Abdelwadoud-ben-kridis/smart-self-balancing-robot/3d/right top leg .stl

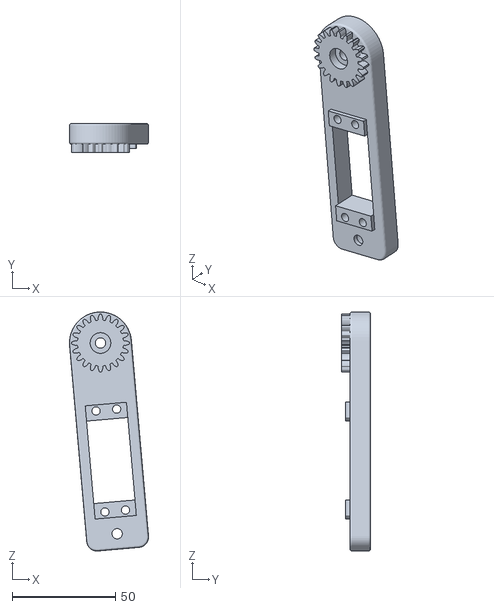
[picture p1: CAD file, 2026-06-13]
3d/right top leg .stl
38.2 x 14.0 x 115.5
