Abdelwadoud-ben-kridis/smart-self-balancing-robot/3d/top.stl

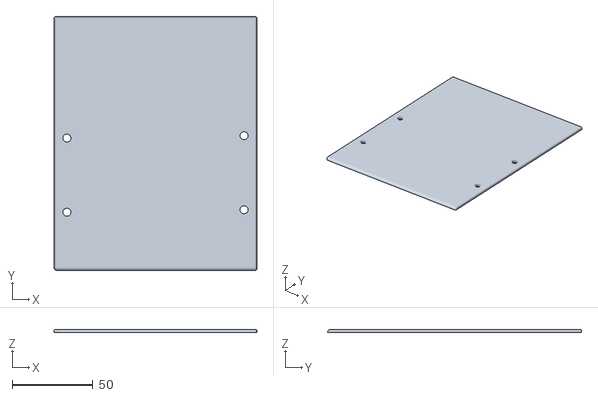
[picture p2: CAD file, 2026-06-10]
3d/top.stl
126.0 x 157.7 x 2.00
