Abdelwadoud-ben-kridis/smart-self-balancing-robot/3d/floor 2.stl

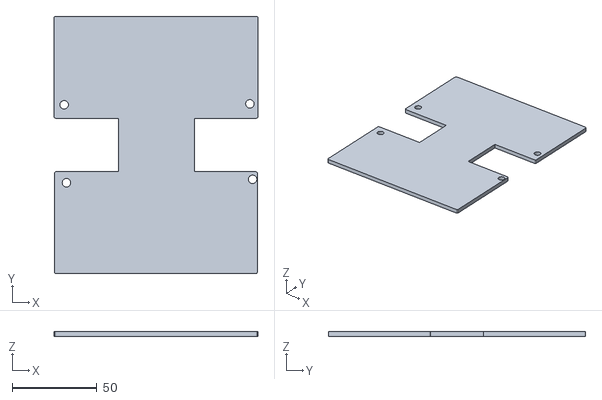
[picture p3: CAD file, 2026-06-10]
3d/floor 2.stl
120.0 x 151.5 x 3.00
