Abdelwadoud-ben-kridis/smart-self-balancing-robot/3d/Left Body_Side_Panel.stl

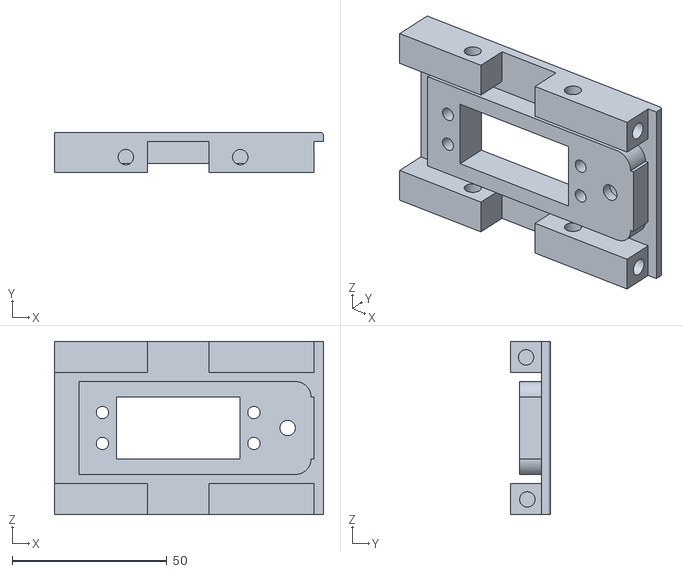
[picture p4: CAD file, 2026-06-10]
3d/Left Body_Side_Panel.stl
87.0 x 13.0 x 56.0
