Abdelwadoud-ben-kridis/smart-self-balancing-robot/3d/front flat.stl

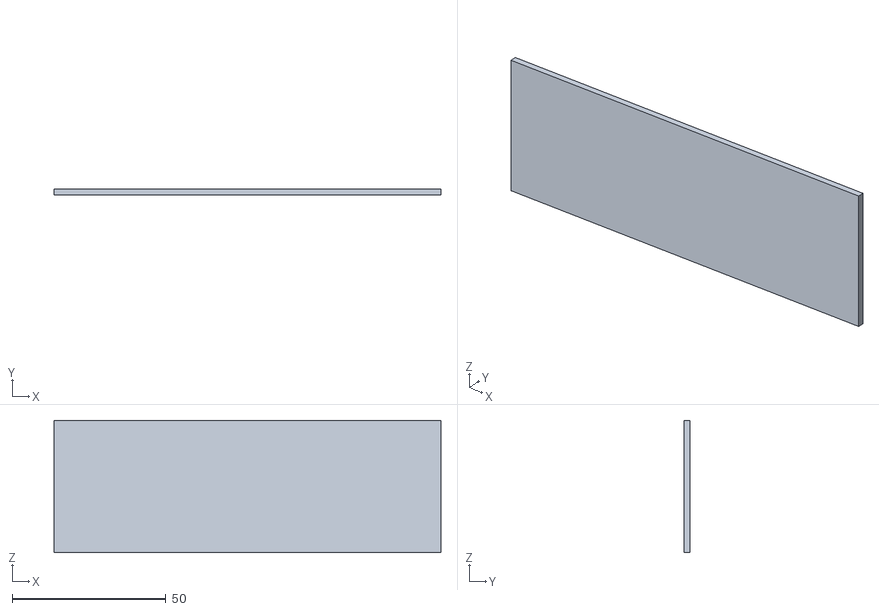
[picture p5: CAD file, 2026-06-08]
3d/front flat.stl
126.0 x 2.00 x 43.0
