Abdelwadoud-ben-kridis/smart-self-balancing-robot/3d/back right.stl

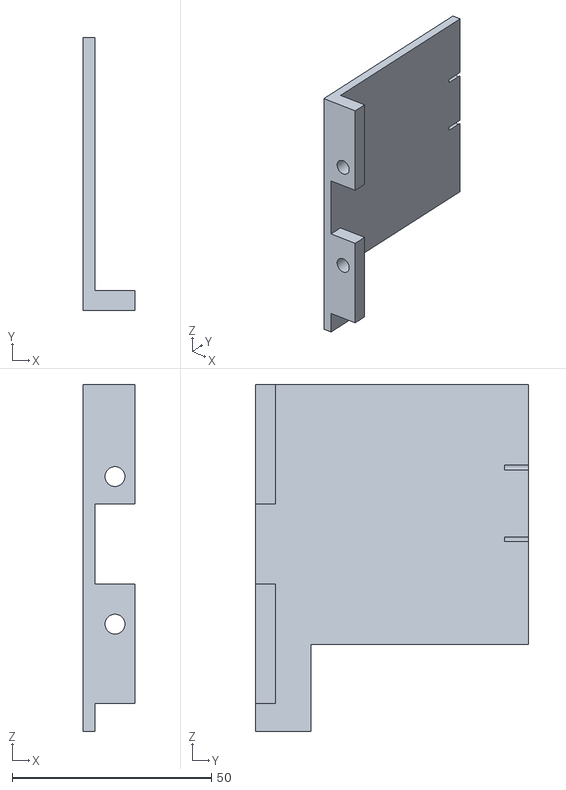
[picture p6: CAD file, 2026-06-08]
3d/back right.stl
13.0 x 68.5 x 87.0
