Abdelwadoud-ben-kridis/smart-self-balancing-robot/3d/bottom.stl

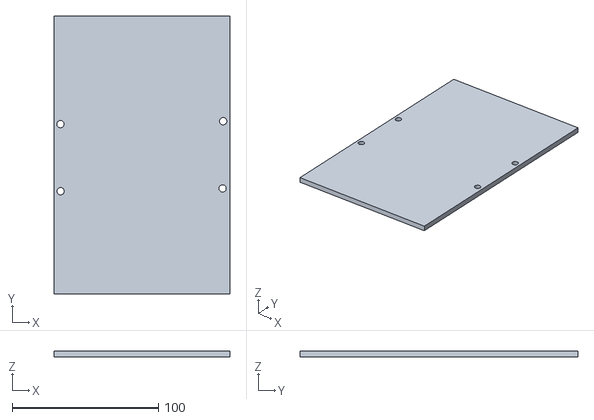
[picture p7: CAD file, 2026-06-08]
3d/bottom.stl
120.0 x 190.0 x 4.00
