Abdelwadoud-ben-kridis/smart-self-balancing-robot/3d/right bottom leg.stl

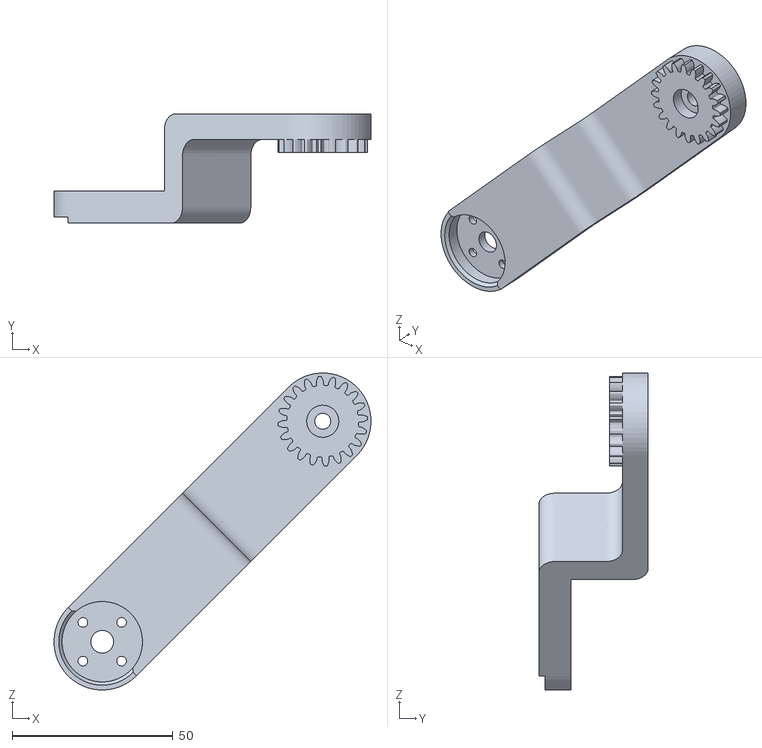
[picture p8: CAD file, 2026-06-08]
3d/right bottom leg.stl
98.5 x 34.0 x 98.5
