Abdelwadoud-ben-kridis/smart-self-balancing-robot/3d/front left.stl

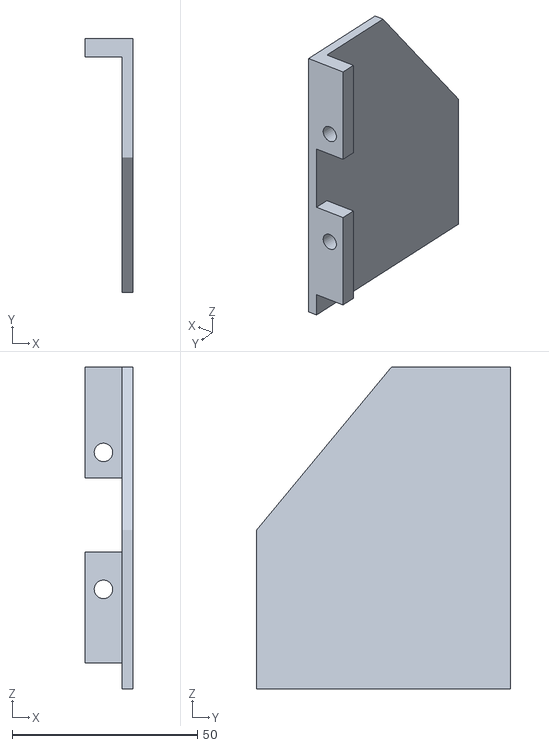
[picture p9: CAD file, 2026-06-08]
3d/front left.stl
13.0 x 68.5 x 87.0
