Abdelwadoud-ben-kridis/smart-self-balancing-robot/3d/back.stl

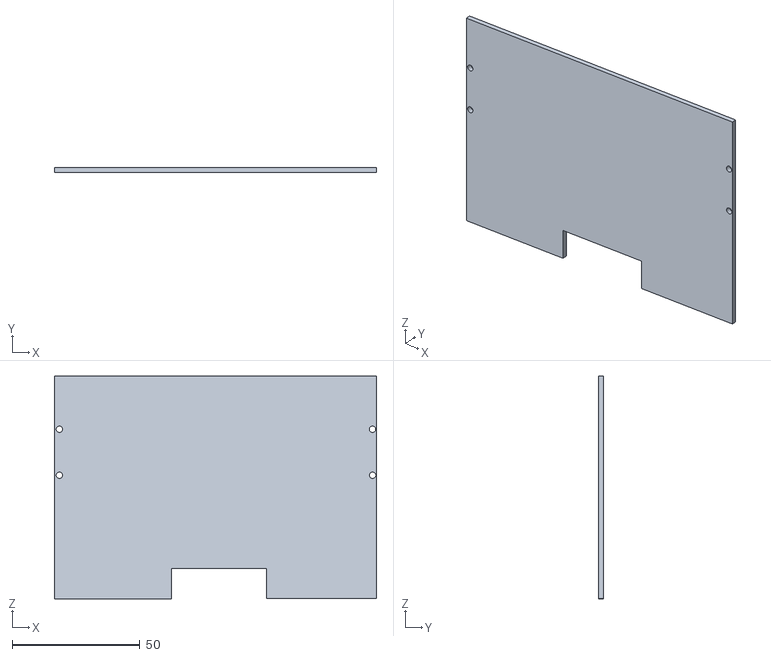
[picture p10: CAD file, 2026-06-08]
3d/back.stl
126.0 x 2.00 x 87.2
