Abdelwadoud-ben-kridis/smart-self-balancing-robot/(list of files, cad)

Other CAD files:
3d/left top leg.stl
3d/Right Body_Side_Panel.stl
3d/left bottom leg .stl
3d/robot.STEP
