Abdelwadoud-ben-kridis/smart-self-balancing-robot/wiring.html

01 SBR

Wiring Plan

◆ Hardware Documentation

# Complete Wiring Plan

Two-floor robot body (18×15 cm). Floor 1 (top): Raspberry Pi 5, ESP32, MPU-6500 GY module, 3.5″ SPI screen. Floor 2 (bottom): 3S battery, BMS, buck converters, TB6612FNG, PCA9685, signal conditioning PCB.

⚡

## Power Chain

11.1V · 3S

Battery feeds a BMS and a master power switch, then fans out to three regulated rails through the main 11.1 V bus.

3S 18650 → BMS → Power Switch → 11.1V Rail

Buck 1

6V

PCA9685 V+ rail and all 4× MG996R servos

Buck 2

5V

Raspberry Pi 5 (USB-C or GPIO 5V pin) and ESP32 VIN

Direct

11.1V

TB6612FNG VM motor power — bypasses regulation

3.3V rail: ESP32 onboard regulator → 3.3V → MPU-6500 VCC, PCA9685 logic VCC, signal conditioning PCB +3V3 rail

☷

## Signal Conditioning PCB

57×60 mm

Central routing board that filters encoder signals, distributes I2C, and breaks out all ESP32 connections through a single 9-pin header.

Power input (J6): pin 1 = +3V3 from ESP32, pin 2 = GND, pin 3 = +6V from Buck 1

J1 — Encoder 1 Left Motor

- 1 +3V3 → encoder VCC
- 2 GND
- 3 ENC1_A → R1 10kΩ → C2 1nF → filtered
- 4 ENC1_B → R2 10kΩ → C3 1nF → filtered

J2 — Encoder 2 Right Motor

- 1 +3V3 → encoder VCC
- 2 GND
- 3 ENC2_A → R3 10kΩ → C6 1nF → filtered
- 4 ENC2_B → R4 10kΩ → C7 1nF → filtered

J8 — IMU MPU-6500

- 1 +3V3 → IMU VCC
- 2 GND
- 3 I2C_SDA
- 4 I2C_SCL
- 5 MPU_INT → R7 4.7kΩ pull-up

J3 — PCA9685 I2C 4-pin

- 1 +3V3
- 2 GND
- 3 I2C_SDA
- 4 I2C_SCL

J4 — PCA9685 Power 2-pin

- 1 +6V
- 2 GND

RC filter cutoff: 1/(2π × 1kΩ × 10nF) ≈ 15.9 kHz — kills motor PWM switching noise

### J5 — ESP32 Output Header (9-pin)

Pin | Signal | ESP32 GPIO
1 | +3V3 | —
2 | GND | —
3 | I2C_SDA | GPIO 21
4 | I2C_SCL | GPIO 22
5 | ENC1_A (filtered) | GPIO 13
6 | ENC1_B (filtered) | GPIO 14
7 | ENC2_A (filtered) | GPIO 16
8 | ENC2_B (filtered) | GPIO 17
9 | MPU_INT | GPIO 4

⚙

## ESP32 GPIO Assignments

WROOM-32D

GPIO | Connected to | Function
21 | PCA9685 SDA | I2C SDA (400 kHz)
22 | PCA9685 SCL | I2C SCL (400 kHz)
5 | MPU-6500 CS | SPI chip select (idle HIGH)
18 | MPU-6500 CLK | SPI clock (VSPI)
19 | MPU-6500 MISO | SPI MISO (VSPI)
23 | MPU-6500 MOSI | SPI MOSI (VSPI)
25 | TB6612FNG PWMA | Left motor speed (PWM, 1 kHz)
26 | TB6612FNG PWMB | Right motor speed (PWM, 1 kHz)
27 | TB6612FNG AIN1 | Left motor direction 1
32 | TB6612FNG AIN2 | Left motor direction 2
33 | TB6612FNG BIN1 | Right motor direction 1
15 | TB6612FNG BIN2 | Right motor direction 2 (HIGH at boot — drive LOW in setup)
4 | MPU-6500 INT | IMU interrupt
13 | ENC1_A | Encoder 1 channel A
14 | ENC1_B | Encoder 1 channel B
16 | ENC2_A | Encoder 2 channel A
17 | ENC2_B | Encoder 2 channel B

⏻

## TB6612FNG Motor Driver

Dual MOSFET H-Bridge

TB6612FNG Pin | Connects to | Notes
VM | 11.1V battery | Motor power (max 15V — OK at 12.6V full charge)
VCC | +3V3 | Logic power
STBY | +3V3 | Tied HIGH — driver always enabled
GND | GND | —
PWMA | GPIO 25 | Left motor speed (PWM, 1 kHz)
AIN1 | GPIO 27 | Left motor direction
AIN2 | GPIO 32 | Left motor direction
PWMB | GPIO 26 | Right motor speed (PWM, 1 kHz)
BIN1 | GPIO 33 | Right motor direction
BIN2 | GPIO 15 | Right motor direction (HIGH at boot)
AO1+AO2 | Left JGB37-520 | Motor terminals
BO1+BO2 | Right JGB37-520 | Motor terminals

↻

## PCA9685 Servo Driver

I2C 0x40

Powered by 6V (V+ rail) and 3.3V (VCC logic). I2C bus from ESP32 via signal conditioning PCB.

Channel | Servo | Direction
CH0 | Left knee MG996R | Normal (pulse 150–600)
CH1 | Right knee MG996R | Reversed (pulse = 750 − normal)
CH2 | Left hip MG996R | Normal
CH3 | Right hip MG996R | Reversed (pulse = 750 − normal)
CH4–15 | Unused | —

Pulse map: 0° = 150, 90° = 375, 180° = 600
Sit position: knee 80°, hip −80° • Stand position: knee 0°, hip 0°

⌖

## MPU-6500 IMU

I2C 0x68

GY breakout module plugs into signal PCB J8 (5-pin socket). Interrupt pin routed through 4.7kΩ pull-up to ESP32.

Axis Convention

Pitch rate = gyro Y (gy)
Pitch angle = atan2(ax, az)

Interrupt

INT pin → R7 4.7kΩ pull-up → J5 pin 9 → ESP32 GPIO (TBD)

π

## Raspberry Pi 5

Floor 1

Power: 5V from Buck 2 → GPIO header pin 4 (or USB-C). Comms with ESP32: UART or USB (TBD).

### 3.5″ SPI Screen (HAT-style, direct on 40-pin header)

Display SPI0

- CS BCM 8
- MISO BCM 9
- MOSI BCM 10
- SCLK BCM 11

Control

- DC BCM 25
- RST BCM 27

Touch

- CS BCM 7
- IRQ BCM 17

⚙

## JGB37-520 Motors

With Encoders

Each motor has 6 wires — 2 for the motor, 4 for the quadrature encoder.

Wire | Color | Connects to
Motor + | — | TB6612FNG AO/BO pins
Motor − | — | TB6612FNG AO/BO pins
Encoder VCC | Red | Signal PCB J1/J2 pin 1 (+3V3)
Encoder GND | Black | Signal PCB J1/J2 pin 2 (GND)
Channel A | Green | Signal PCB J1/J2 pin 3
Channel B | White | Signal PCB J1/J2 pin 4

◎

## MG996R Servos

4× Joints

Standard 3-wire servo connectors plug directly into PCA9685 channel headers.

Wire | Color | Connects to
GND | Brown | PCA9685 GND rail
Power | Red | +6V (Buck 1 via PCA9685 V+ rail)
Signal | Orange | PCA9685 channel PWM output

↑
