Abdelwadoud-ben-kridis/smart-self-balancing-robot/pcb/robot pcb.kicad_pcb

## KiCad design pcb/robot pcb.kicad_pcb (2026-06-02)

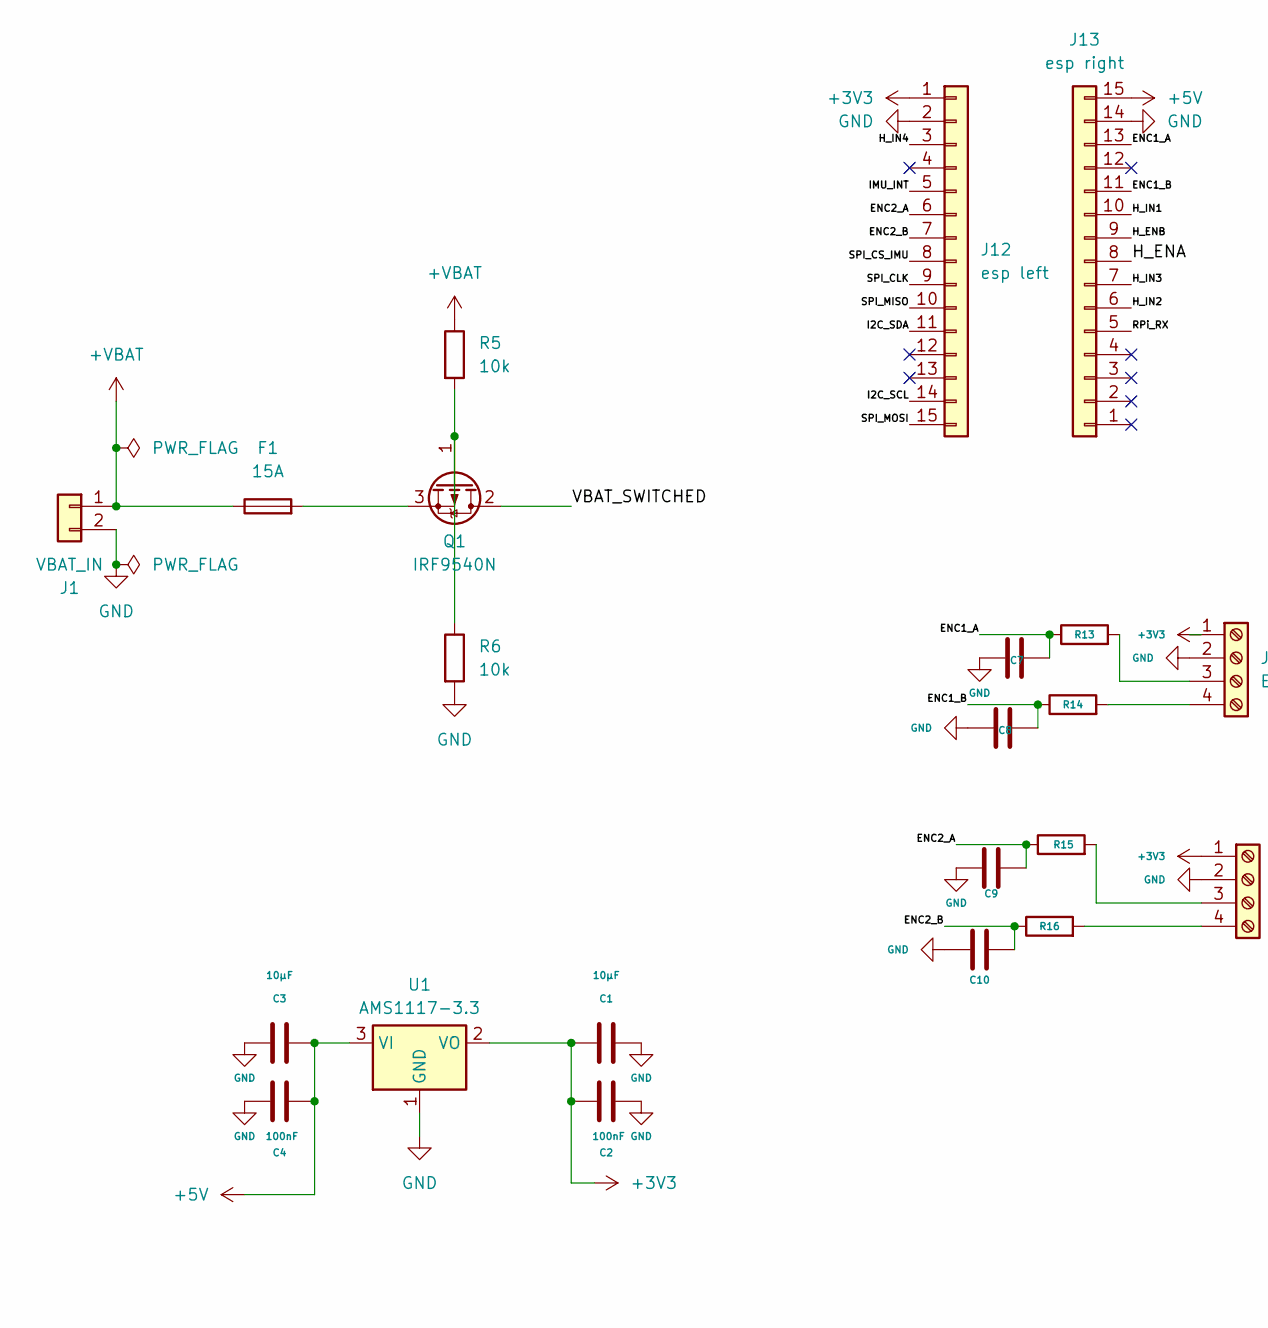
[picture p11: schematic robot pcb.kicad_sch, part in row 1, column 1]

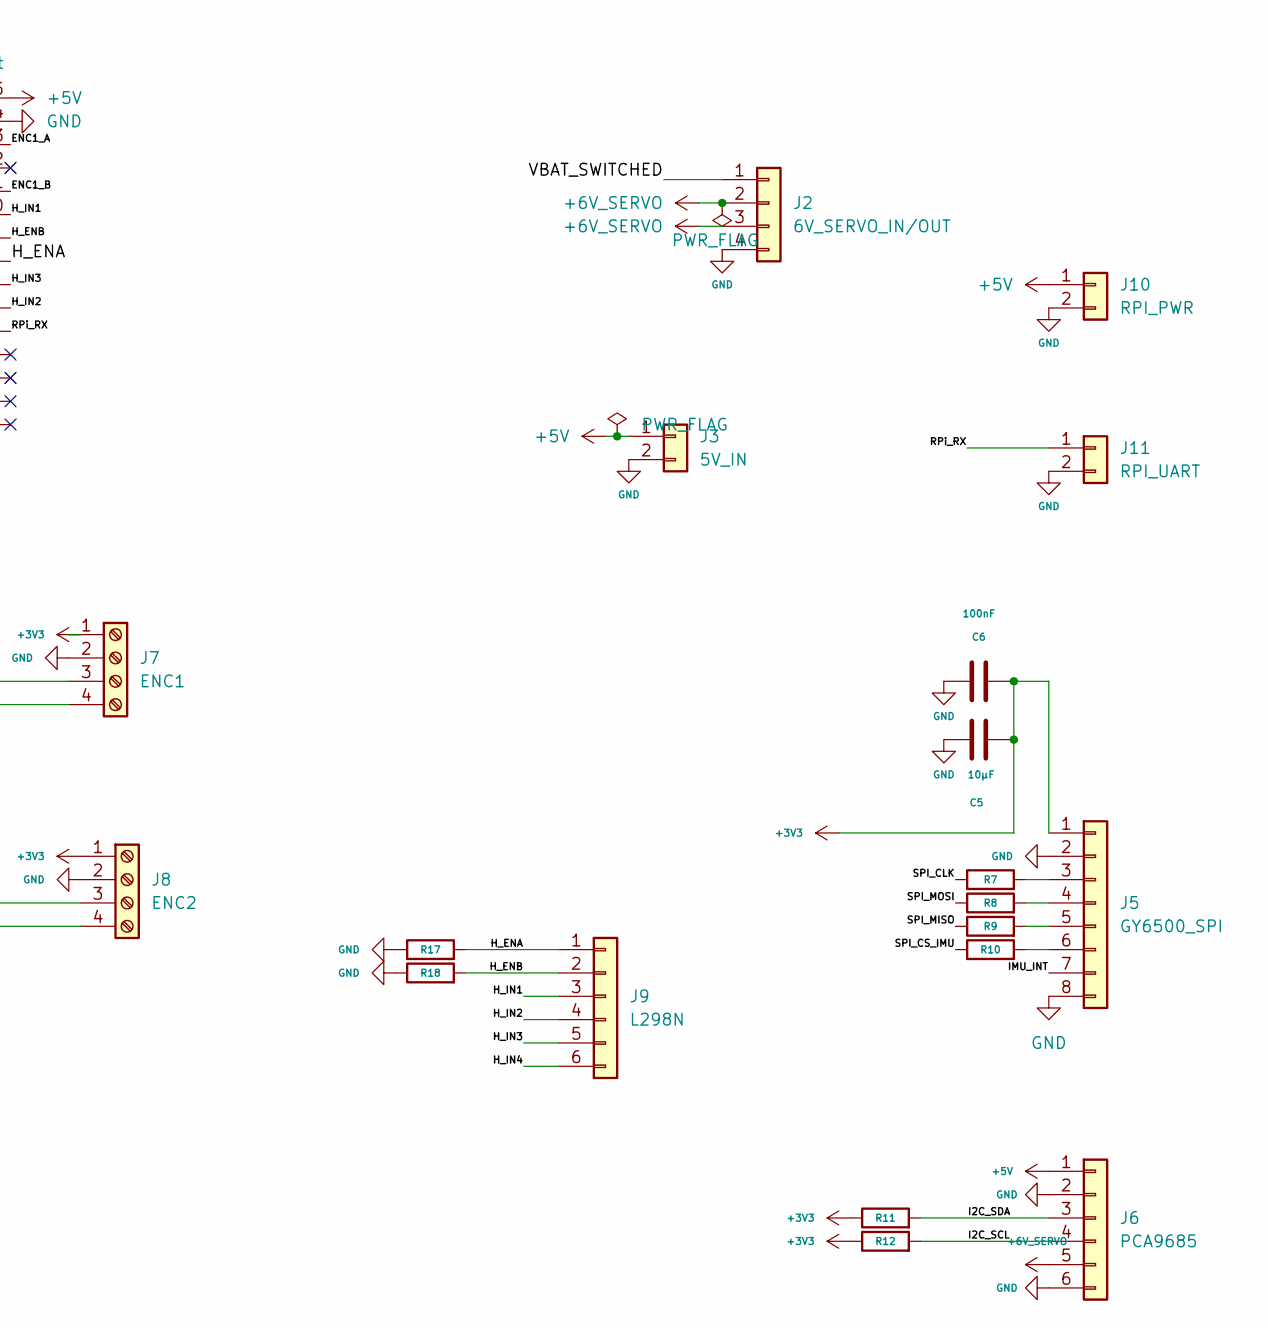
[picture p12: schematic robot pcb.kicad_sch, part in row 1, column 2]

Parts:
C1, C3, C5: 10µF; CP_Radial_D5.0mm_P2.50mm
C2, C4, C6: 100nF; C_Disc_D3.8mm_W2.6mm_P2.50mm
C7, C8, C9, C10: C; C_Disc_D3.8mm_W2.6mm_P2.50mm
F1: 15A; Fuseholder_Cylinder-5x20mm_Schurter_FPG4_Vertical_Closed
J1: VBAT_IN; PinHeader_1x02_P2.54mm_Vertical
J2: 6V_SERVO_IN/OUT; PinHeader_1x04_P2.54mm_Vertical
J3: 5V_IN; PinHeader_1x02_P2.54mm_Vertical
J5: GY6500_SPI; PinHeader_1x08_P2.54mm_Vertical
J6: PCA9685; PinHeader_1x06_P2.54mm_Vertical
J7: ENC1; TerminalBlock_MaiXu_MX126-5.0-04P_1x04_P5.00mm
J8: ENC2; TerminalBlock_MaiXu_MX126-5.0-04P_1x04_P5.00mm
J9: L298N; PinHeader_1x06_P2.54mm_Vertical
J10: RPI_PWR; PinHeader_1x02_P2.54mm_Vertical
J11: RPI_UART; PinHeader_1x02_P2.54mm_Vertical
J12: esp left; PinSocket_1x15_P2.54mm_Vertical
J13: esp right; PinSocket_1x15_P2.54mm_Vertical
Q1: IRF9540N; TO-220-3_Vertical
R5, R6: 10k; R_Axial_DIN0207_L6.3mm_D2.5mm_P10.16mm_Horizontal
R7, R8, R9, R10: 33; R_Axial_DIN0207_L6.3mm_D2.5mm_P10.16mm_Horizontal
R11, R12: 4.7k; R_Axial_DIN0207_L6.3mm_D2.5mm_P10.16mm_Horizontal
R13, R14, R15, R16: 1k; R_Axial_DIN0207_L6.3mm_D2.5mm_P10.16mm_Horizontal
R17, R18: 10kΩ; R_Axial_DIN0207_L6.3mm_D2.5mm_P10.16mm_Horizontal
U1: AMS1117-3.3; SOT-223-3_TabPin2

Connections:
+3V3: C1.2, C2.2, C5.1, C6.1, J5.1, J7.1, J8.1, J12.1, R11.1, R12.1, U1.2 (VO)
+5V: C3.1, C4.1, J3.1, J6.1, J10.1, J13.15, U1.3 (VI)
+6V_SERVO: J2.2, J2.3, J6.5
+VBAT: F1.1, J1.1, R5.1
/ENC1_A: C7.2, J13.13, R13.1
/ENC1_B: C8.2, J13.11, R14.1
/ENC2_A: C9.2, J12.6, R15.1
/ENC2_B: C10.2, J12.7, R16.1
/H_ENA: J9.1, J13.8, R17.2
/H_ENB: J9.2, J13.9, R18.2
/H_IN1: J9.3, J13.10
/H_IN2: J9.4, J13.6
/H_IN3: J9.5, J13.7
/H_IN4: J9.6, J12.3
/I2C_SCL: J6.4, J12.14, R12.2
/I2C_SDA: J6.3, J12.11, R11.2
/IMU_INT: J5.7, J12.5
/RPi_RX: J11.1, J13.5
/SPI_CLK: J12.9, R7.1
/SPI_CS_IMU: J12.8, R10.1
/SPI_MISO: J12.10, R9.1
/SPI_MOSI: J12.15, R8.1
/VBAT_SWITCHED: J2.1, Q1.2 (D)
GND: C1.1, C2.1, C3.2, C4.2, C5.2, C6.2, C7.1, C8.1, C9.1, C10.1, J1.2, J2.4, J3.2, J5.2, J5.8, J6.2, J6.6, J7.2, J8.2, J10.2, J11.2, J12.2, J13.14, R6.2, R17.1, R18.1, U1.1 (GND)
unnamed: J5.3, R7.2
unnamed: J5.4, R8.2
unnamed: J5.5, R9.2
unnamed: J5.6, R10.2
unnamed: J7.3, R13.2
unnamed: J7.4, R14.2
unnamed: J8.3, R15.2
unnamed: J8.4, R16.2
unnamed: Q1.1 (G), R5.2, R6.1
unnamed: F1.2, Q1.3 (S)

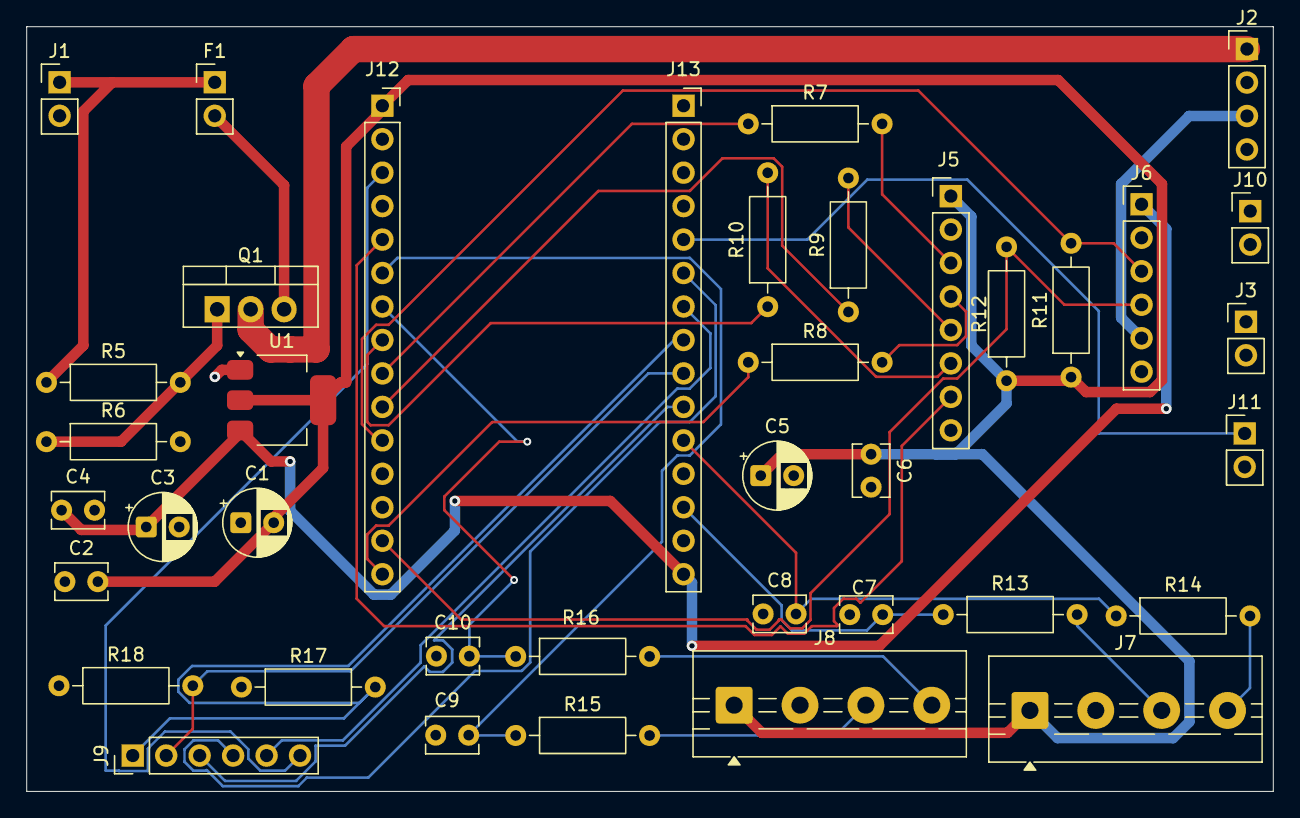
[picture p13: board robot pcb.kicad_pcb from above]

Board: 4 copper layers, 94.6 x 58.1 mm, 39 parts (0 on the bottom side), 34 nets.
