Abdelwadoud-ben-kridis/smart-self-balancing-robot/(commit log)

2026-05-19 Add complete wiring plan for the two-floor robot body
    Covers power chain, signal conditioning PCB, ESP32 GPIO assignments,
    L298N motor driver, PCA9685 servo driver, MPU-6500 IMU, Raspberry Pi 5,
    JGA25-370 motors with encoders, and MG996R servos.
2026-05-26 Create PCB Bill of Materials for robot project
    Added PCB Bill of Materials for self-balancing articulated leg robot, detailing project overview, power rails, and components.
2026-05-27 Update pcbBOM
2026-06-02 Rename robot pcb.kicad_pcb to pcb_files/robot pcb.kicad_pcb
    [robot pcb.kicad_pcb]
2026-06-02 Add website with GitHub Pages deployment
    - index.html with 3D/Photo toggle button and no custom cursor
    - robot.glb for the 3D model viewer
    - GitHub Pages workflow
2026-06-02 Consolidate all PCB files into pcb/ folder
    Moved kicad_pro, kicad_sch, kicad_pcb, kicad_prl, and BOM into pcb/.
    Removed empty pcb_files/a.md placeholder.
    Backups stored locally in pcb/backups/ (gitignored).
    [robot pcb.kicad_pcb, robot pcb.kicad_sch]
2026-06-02 Add 3D model files (STEP, F3Z, STL)
2026-06-02 Rename 3d/expansion board esp 32 shield CAD.STEP to robot
2026-06-02 Add PCB Showcase, 3D Models, and Behind the Design sections
    - PCB section: component explorer, board specs, download links, signal flow diagram
    - 3D Models: interactive STL viewer with Three.js, model cards, assembly stats
    - Behind the Design: 4 engineering decision cards explaining key choices
    - Updated navigation, footer, and scroll tracking for all new sections
2026-06-02 Fix PCB specs to match Rev C BOM
    - Board: 94.6x58.1mm (not 100x80)
    - Rev C (not Rev A)
    - 1oz all layers (not 1oz/0.5oz)
    - Correct stackup: F.Signal/GND/Power/B.Signal
    - Add power trace widths, DRC status
    - Fix component descriptions (XL4016 bucks, IRF9540N protection)
2026-06-02 Fix PCB component explorer to match actual BOM Rev C
    - Split into On-Board (40 components) and External Modules sections
    - On-board: IRF9540N, AMS1117, ESP32 sockets, J9 L298N control,
    GY-6500 socket, PCA9685 socket, encoder RC filters, passives
    - External: ESP32, L298N, GY-6500/MPU-6500, PCA9685, XL4016 bucks, Pi 5
    - Removed fake VL53L0X/MPU-9250 entries (not on this PCB)
    - All descriptions match pcbBOM Rev C pinouts and notes
2026-06-02 Visual redesign: layout rhythm, typography, animations, color
    - Full-bleed cinematic moments (PCB hero, 3D viewer, gallery)
    - Section color identity (green PCB, amber power, purple models)
    - Typography scale variation (XL titles, quiet titles, pull quotes)
    - 3 cinematic stat dividers between major sections
    - New scroll animations: slide-left/right, scale-up, stagger
    - PCB: terminal-style spec table, colored component borders
    - Behind the Design: magazine alternating layout
    - Downloads/stats: horizontal strips instead of card grids
2026-06-02 Redesign nav and warm up background
    - Nav: clean horizontal bar with brand left, links center, status right
    Dropped section numbers, reduced to 9 key links, normal case
    Subtle backdrop blur, active link in accent color
    - Background: #161616 (warm neutral) replaces #111318 (cold blue)
    - Selection/scrollbar colors aligned to accent
    - Scroll progress bar uses accent not cyan
2026-06-02 Fix layout: wider container, single-column flow, breathing room
    - 1080px max-width (was 960, too cramped for grids)
    - Section padding 80px with subtle divider lines between
    - Hero: auto height instead of 100vh, less cramped
    - Pillars: 2 columns instead of 4 tiny ones
    - Mech/Elec grids: single column, content stacks vertically
    - Spec table values: 14px (was 17px, too loud)
    - Cards: solid bg-2 background, no glass/blur
    - Section divider borders for visual rhythm
    - Kill scroll-hint, floor-label glows, pillar top-bars
2026-06-03 Redesign website: Tesla/Apple-inspired dark theme, concise layout
    Complete visual overhaul from engineering notebook to premium portfolio:
    - Pure black background with warm orange accent (#ff6b35)
    - Massive typography scale (72-96px hero, 48-64px sections)
    - 6 concise sections: Features, Architecture, Engineering, PCB, CAD, Gallery
    - SEO: Open Graph, Twitter Cards, structured meta tags
    - Clean feature cards, flow diagrams, tabbed engineering specs
    - Preserved Three.js GLB + STL 3D viewers
    - Mobile-responsive with hamburger nav
    - Reduced from 5500 to 2100 lines
2026-06-03 Fix download links: use blob URLs for GitHub file downloads
    Raw URLs open as text in browser. Blob URLs show the GitHub file
    page with a proper download button.
2026-06-03 Fix STEP file link: correct filename is robot.STEP, not expansion board
2026-06-03 Add computer vision to feature cards and engineering subtitle
    Replace Encoder Feedback card with Computer Vision card highlighting
    Pi 5, YOLOv8n, MediaPipe, person following, gesture control. Update
    engineering subtitle to mention computer vision. Add mobile responsive
    rule for Vision & AI tab grid.
2026-06-03 Improve visual hierarchy, PCB showcase, hero metrics, and SEO
    - Hero: accent-colored title, tech pills, 4-stat metrics strip
    - PCB: stats banner, feature highlight cards, side-by-side tables
    - Architecture: feedback loop indicator, wrapped in styled card
    - Gallery: larger cards (440px), descriptive alt text
    - SEO: JSON-LD structured data, improved title/meta/OG tags
    - Feature cards: icon backgrounds, accent top-border on hover
    - Section eyebrows for visual hierarchy
    - Footer: credit line update
2026-06-03 Fix 6 ESP32 firmware bugs and website mismatches
    1. comms: reset drive_active/speed/turn each loop so drive commands
    don't persist after Pi stops sending
    2. servos: sit from current interpolation step instead of jumping
    to fully-stood position first
    3. website: correct IMU interface from SPI to I2C to match code
    4. website: update PID values to match config.h (Ki=1.0, Kd=1.5)
    5. servos: add servos_get_dir() getter, stop accessing _interp_dir
    directly from control.ino
    6. motors: migrate from deprecated ledcSetup/ledcAttachPin to
    ledcAttach for ESP32 Arduino Core v3.0+ compatibility
    [comms.h, config.h, control.ino, motors.h, servos.h]
2026-06-08 Add individual 3D-printed part STL files
    Add 13 STL files for all robot body and leg components:
    body panels, floor, top, bottom, front, back, and leg parts.
    [Body_Side_Panel left.stl, Body_Side_Panel.stl, back right.stl, back.stl, bottom.stl, floor 2.stl, front flat.stl, front left.stl]
2026-06-08 Fix BOM inconsistencies across index.html and wiring.html
    - Replace TB6612FNG with L298N in index.html (4 occurrences)
    - Fix IMU interface: I2C -> SPI in index.html component tables
    - Update GPIO assignments in wiring.html to match PCB Rev C
    (ENB=GPIO26, IN1=GPIO27, IN2=GPIO32, IN4=GPIO15, IMU_INT=GPIO4)
    - Fill in TBD encoder GPIOs (13/14/16/17) and IMU_INT (GPIO4)
    - Add SPI bus pins (GPIO 5/18/19/23) for MPU-6500
    - Fix RC filter values: 10kohm x 1nF -> 1kohm x 10nF
2026-06-08 Add system-level Bill of Materials (42 components)
2026-06-08 Add PETG print settings for Ender 3 Max with per-part overrides
    Covers general PETG profile (235C nozzle, 80C bed, 25% gyroid),
    per-part infill/wall overrides for structural legs (40%, 4 walls),
    and Ender 3 Max-specific tips for bed adhesion and stringing.
2026-06-08 Fix PETG print settings for Bowden setup
    - Retraction distance 5mm -> 6.5mm (Bowden tube needs more)
    - First layer temp 240C -> 238C (stock PTFE degrades above 240C)
    - Add PTFE tube temperature limit warning
2026-06-08 Bump bed temp to 85C for better PETG adhesion on carborundum glass
    85C is right above PETG glass transition temp, gives strongest
    first-layer bond on the Ender 3 Max carborundum bed.
2026-06-08 Update print settings for eSUN gray PETG filament
    - Nozzle temp 235->240C (eSUN optimal is 245C but PTFE caps at 240C)
    - Bed temp 85->80C (eSUN max recommended is 80C)
    - Add note about PTFE vs eSUN temp conflict and upgrade path
2026-06-08 Lower bed temp to 70C (mid-range of eSUN 60-80C spec)
    First layer at 75C for slightly better adhesion, then 70C
    for remaining layers. Reduces risk of PETG bonding too
    aggressively to carborundum glass.
2026-06-08 Add support settings section for PETG prints
    Tree/organic supports at 50 deg threshold, 0.2mm Z distance,
    support interface enabled for clean surfaces. Per-part guidance
    on which parts likely need supports.
2026-06-08 Use Lines infill at 20% for bottom.stl (faster, low-stress part)
2026-06-08 Switch bottom.stl infill from Lines to Grid (10 min difference)
2026-06-08 Bump bottom.stl infill to 25% to match other body parts
2026-06-10 Replace side panels with updated Left/Right Body_Side_Panel STLs
    Remove old Body_Side_Panel.stl and Body_Side_Panel left.stl,
    add new Right Body_Side_Panel.stl and Left Body_Side_Panel.stl.
    [Body_Side_Panel left.stl, Body_Side_Panel.stl, Left Body_Side_Panel.stl, Right Body_Side_Panel.stl]
2026-06-10 Redesign website with machined-steel + signal-orange palette
    - index.html: full redesign per new section layout — hero with robot
    render, about, hardware cards, 3D design gallery with lightbox,
    animated PID control-loop diagram, PCB showcase, GitHub CTA, footer.
    Responsive, scroll-reveal animations, Space Grotesk / Inter /
    JetBrains Mono typography.
    - PRB.html / wiring.html: re-themed to the same palette (orange #ff6b2b,
    cyan #38bdf8, steel-dark backgrounds) and typography; content unchanged.
    - PRB.html: added Home links back to the main page.
2026-06-10 Add engineering.html — previous website preserved as engineering doc
    Restored the pre-redesign index.html as a standalone page: retitled,
    fixed canonical/og:url, added Home link. Linked from the main page nav
    and footer (PRB keeps its own entry).
2026-06-10 Replace engineering.html with new professional engineering reference
    Written from scratch (not the old website): system architecture and
    UART protocol, control system (state machine, complementary filter,
    PID), power tree, 4-layer distribution PCB and connector map, full
    ESP32 GPIO table, actuators, PETG mechanical design, firmware module
    breakdown, and safety/known-issues section with pre-power checklist.
    All values sourced from the Rev C design files (WIRING.md, BOM.md,
    pcbBOM, esp32 firmware, PRINT_SETTINGS.md). Sidebar TOC with
    scroll-spy, same palette as the redesigned site.
2026-06-10 Mark J6.P5 servo rail error as fixed across docs
    PCA9685 V+ (J6.P5) net corrected from +5V to +6V_SERVO. Updated the
    engineering doc status/known-issues/checklist, WIRING.md, and pcbBOM.
    Re-DRC + Gerber re-export still noted as required before ordering.
2026-06-10 Update drive motors to JGB37-520 across living docs
    Renamed JGA25-370 (and pcbBOM JGA37-370 typo) to JGB37-520 in
    index.html, engineering.html, wiring.html, WIRING.md, BOM.md and
    pcbBOM. Spec text updated; flagged stall-current check vs L298N.
    PRB.html left unchanged as a dated design-review snapshot.
2026-06-10 Replace L298N with TB6612FNG motor driver across docs and firmware refs
    Signal-compatible swap on J9: ENA/ENB/IN1-4 nets now map to
    PWMA/PWMB/AIN1/AIN2/BIN1/BIN2. Power scheme updated: VM direct to
    11.1V battery (was VSS), VCC + STBY on +3V3 (was 5V logic), no
    jumpers. Ratings (1.2A cont / 3.2A peak, MOSFET low-drop) and brake/
    coast truth table documented. Updated WIRING.md, wiring.html,
    engineering.html, index.html, BOM.md, pcbBOM, config.h comment, and
    the Pi display boot line. PRB.html left as dated snapshot; KiCad J9
    label still says L298N until edited in KiCad.
    [config.h, display.py]
2026-06-10 Firmware v1.1 — retarget to Rev C PCB + TB6612FNG, fix control bugs
    - config.h: full Rev C pin map (SPI IMU on 5/18/19/23, TB6612FNG on
    25/26/27/32/33/15, encoders 13/14 + 16/17, Pi UART RX on GPIO35,
    TX unassigned until a telemetry wire exists)
    - sensors.h: rewritten for SPI MPU-6500 (I2C_IF_DIS, WHO_AM_I check,
    DLPF 41Hz, +/-500dps) with boot-time gyro bias calibration
    - encoders.h (new): interrupt-driven quadrature counting, exposed in
    the P debug command
    - motors.h: TB6612FNG logic + motors_failsafe() driving all motor
    pins LOW as the first lines of setup() (GPIO15 boots HIGH)
    - control.ino: drift-free loop timing, derivative-on-measurement PID
    with low-pass D filter, PID s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
    [comms.h, config.h, control.ino, encoders.h, motors.h, sensors.h, servos.h]
2026-06-10 Replace floor 2.stl with updated model
    [floor 2.stl]
2026-06-10 Replace top.stl with updated model
    [top.stl]
2026-06-11 Revise PCB BOM for Revision C with corrections
    Updated PCB Bill of Materials for Revision C, including corrections to component values, descriptions, and connector specifications. Fixed J6.P5 connection to +6V_SERVO and updated high-current connector recommendations.
2026-06-13 Update top leg STL files with new designs
    [left top leg.stl, right top leg .stl]
